FylloClip/tutorial/index.qmd

---
title: "FylloClip tutorial"
---

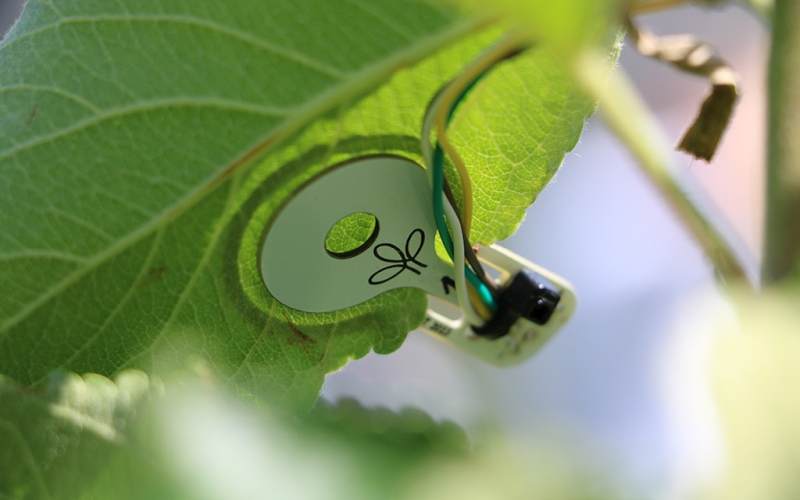
[picture p18: images/FylloClip.jpg]


This tutorial aims to enable anyone to create and deploy their own fully functional FylloClip module capable of remote data transmission via the LoRaWAN network. It will guide you from ordering PCBs (printed circuit boards), purchasing electronic components, assembling and programming the system, to setting up remote data transmission. Ultimately, this will enable you to remotely monitor the water status of plants, transmitting data from the field to the cloud. Consequently, you can check on your PC or mobile phone, anytime and anywhere, if they are experiencing water stress.

This entire system can be replicated at a very low cost and requires only basic electronics skills (like soldering) and some familiarity with microcontrollers, particularly Arduino.

**What can a FylloClip sensor do and what can't it do?**

FylloClip sensors can provide reliable indications of whether a plant is optimally supplied with water or if drought stress due to water deficiency is setting in.

FylloClip sensors do not measure transpiration rates, although the signal of the capacitive part is strongly influenced by the transpiration of the leaf. Therefore, FylloClip sensors are not porometers. They provide a qualitative information regarding the water status of a plant, and not a quantitative reference value.

**What is the ideal application area for FylloClip sensors?**

FylloClip sensors are particularly suitable for plants with deep or widely extensive root systems, where soil moisture sensors, due to their very localized measurements, have only limited significance. FylloClip sensors provide information about the general water status of plants as affected by the availability of water in the entire soil volume explored by their roots.

The scientific background and working principle of these foliar sensors, named 'FylloClip' due to their paperclip-like attachment, are explained in detail in the following publication:\
[*A leaf-mounted capacitance sensor for continuous monitoring of foliar transpiration and solar irradiance as an indicator of plant water status*](https://www.agroengineering.org/jae/article/view/1477/1066)

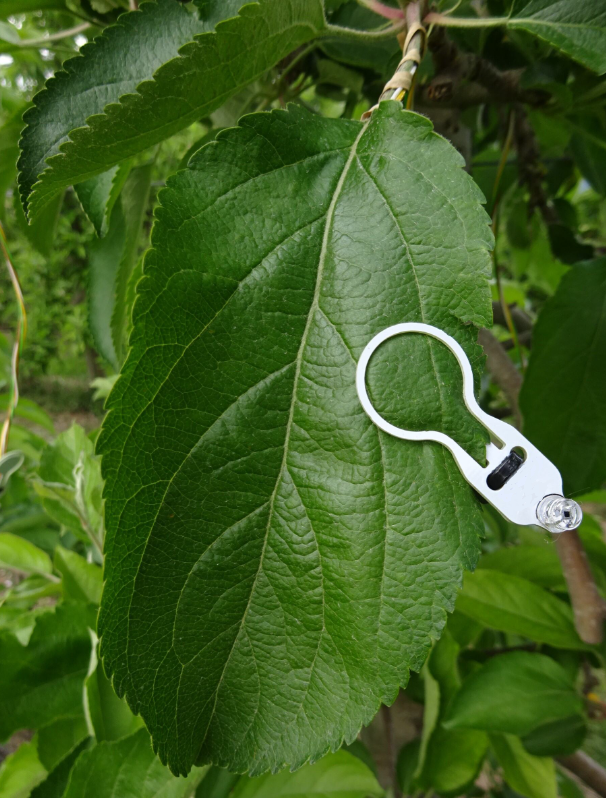
[picture p19: images/fylloclip_apple.png]
FylloClip sensor on apple leaf


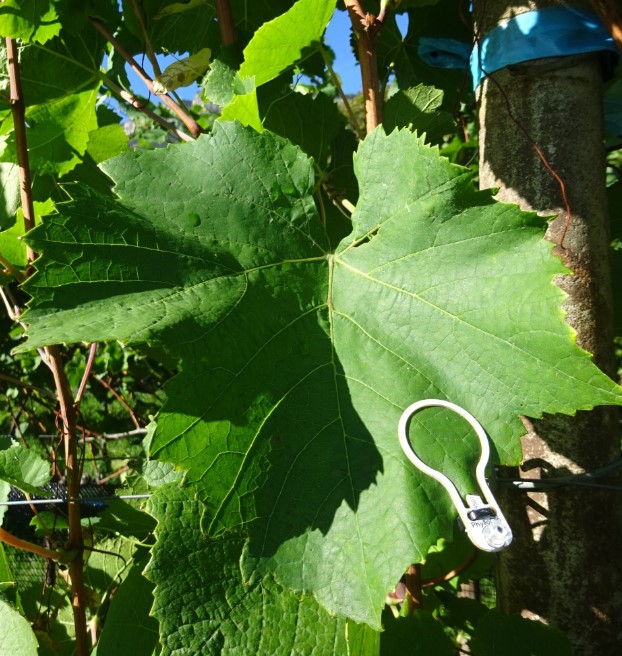
[picture p20: images/grapevine.jpg]
FylloClip on grapevine


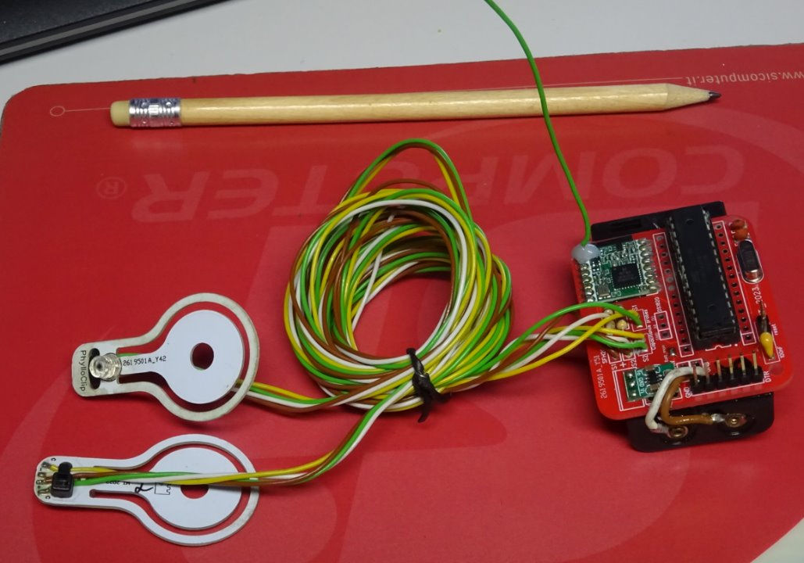
[picture p21: images/clipboard-4003555692.png]
![](images/clipboard-2063268666.png){width="440"}


A fully assembled FylloClip module

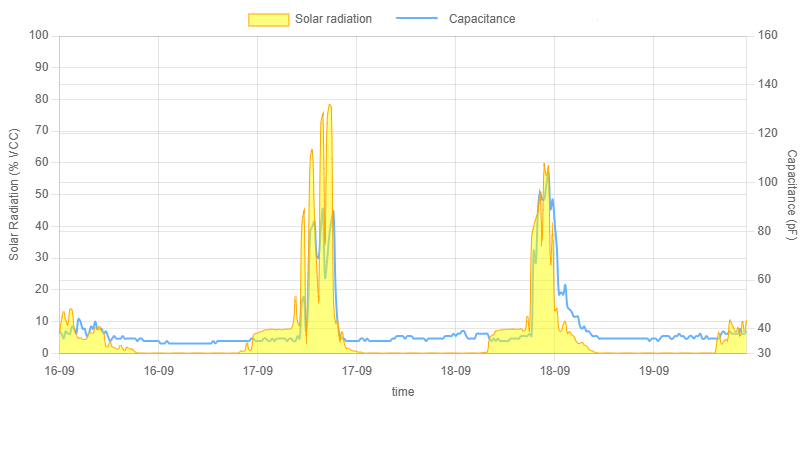
[picture p22: images/Graph_sensor_output_1.png]
Example of sensor output on a well watered plant: the capacitance values closely follow the pattern of solar radiation.


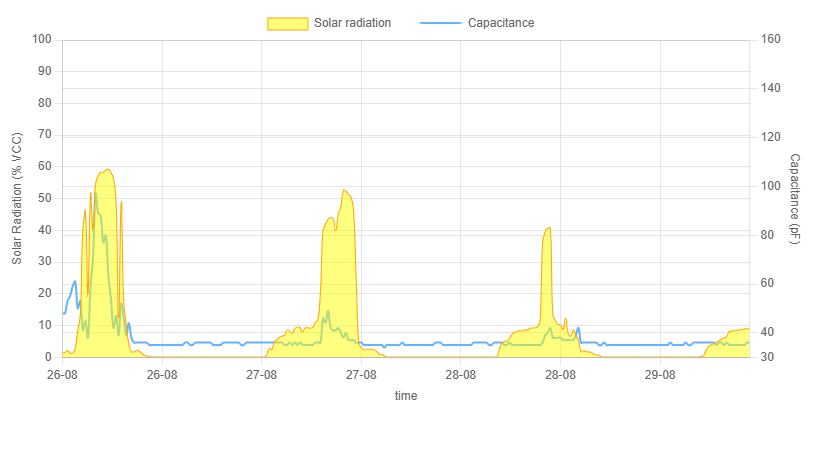
[picture p23: images/Graph_sensor_output_2.png]
Example of sensor output showing the onset of water stress through an early drop in capacitance that increasingly deviates from the pattern of solar radiation.
