FylloClip/tutorial/content/PCBs.qmd

---
title: "PCBs"
---

Here you can download the production files for the PCB needed to create the control unit (Arduino board) as well as the PCBs used as foliar sensors.

The files are provided in two different formats, gerber and EasyEDA. The gerber files can be used directly to place an order with a PCB manufacturer, whereas the EasyEDA files can be uploaded to the [EasyEDA](https://easyeda.com/ "EasyEDA PCB design software") PCB design software where they can be edited and modified before placing an order.

#### **Arduino board**

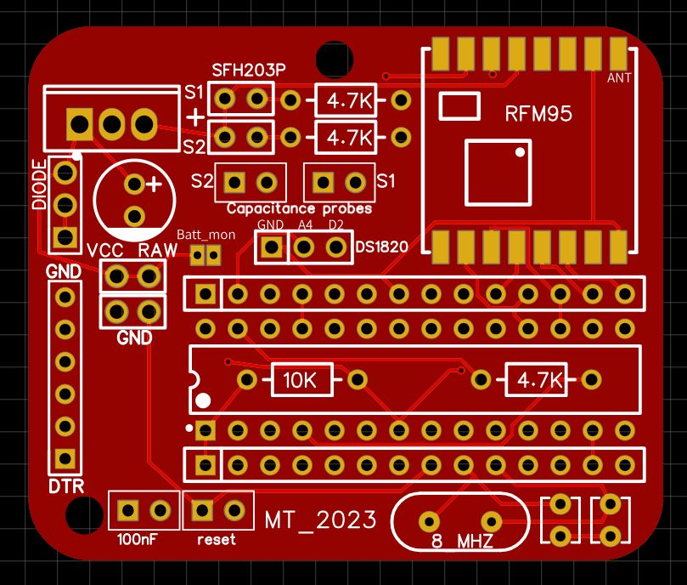
[picture p57: images/Arduino_board.jpg]
Arduino board PCB


[Gerber format](https://github.com/FylloClip/tutorial/blob/main/resources/PCB%20production%20files/Arduino_board/gerber/Gerber_PCB_Arduino_LoRa_board.zip)

[EasyEDA format](https://github.com/FylloClip/tutorial/blob/main/resources/PCB%20production%20files/Arduino_board/EasyEda/PCB_Arduino_LoRa_board.json)

#### **FylloClip sensors**

When ordering the foliar sensors, [please make sure to select a PCB **thickness of 1 mm**]{.underline}. If the thickness is more than 1 mm, the sensor will be too stiff an difficult to be placed on a leaf. I have always chosen the white colour, but probably it does not make much of a difference if you choose another colour.

**larger size:**

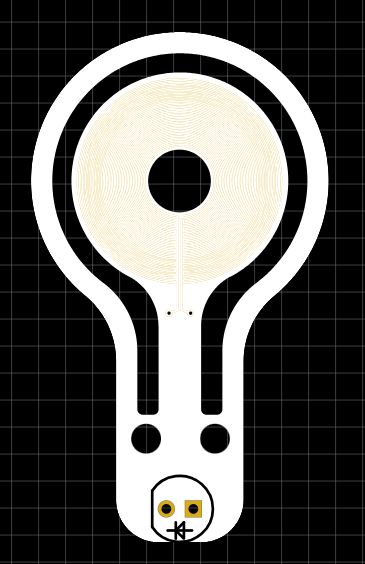
[picture p58: images/FylloClip_large_size.jpg]
foliar sensor, larger size


[Gerber format](https://github.com/FylloClip/tutorial/blob/main/resources/PCB%20production%20files/foliar_sensor/gerber/Gerber_larger_size.zip)

[EasyEDA format](https://github.com/FylloClip/tutorial/blob/main/rssources/PCB%20production%20files/foliar_sensor/EasyEda/larger_size_sensor.json)

**smaller size:**

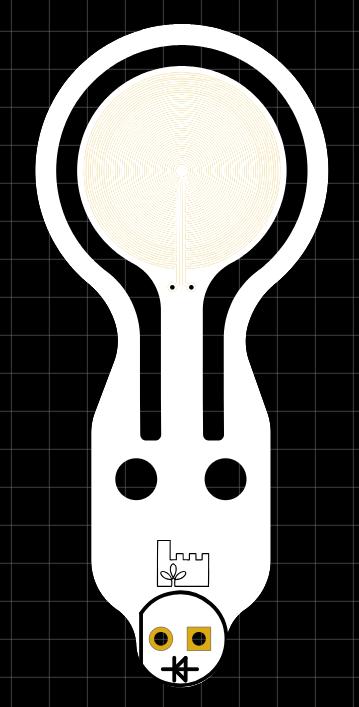
[picture p59: images/clipboard-2212851997.png]
foliar sensor, smaller size


[Gerber format](https://github.com/FylloClip/tutorial/blob/main/resources/PCB%20production%20files/foliar_sensor/gerber/Gerber_small_size.zip)

[EasyEDA format](https://github.com/FylloClip/tutorial/blob/main/resources/PCB%20production%20files/foliar_sensor/EasyEda/small_size_sensor.json)
