FylloClip/tutorial/content/data_interpretation.qmd

---
title: "data interpretation"
---

🚧 This section is under construction.
