FylloClip/tutorial/content/legal_note.qmd

---
title: "legal note"
---

All information provided in this tutorial, including schematics and code, is freely available for personal and commercial use. However, the name **"FylloClip"** is a legally protected trademark of the [**Laimburg Research Centre**](https://www.laimburg.it/en/home).\
Any commercial use of the name **"FylloClip"** requires prior formal authorization from the Laimburg Research Centre.
