FylloClip/tutorial/images/clipboard-74721871.png

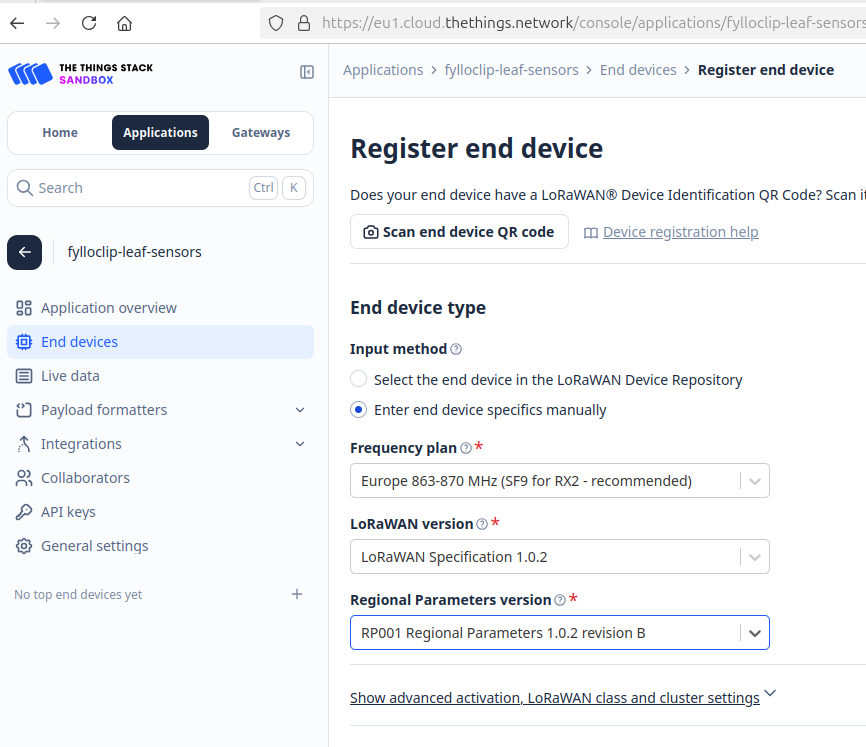
images/clipboard-74721871.png
