FylloClip/tutorial/images/clipboard-165344629.png

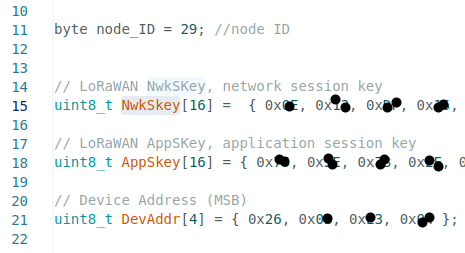
images/clipboard-165344629.png
