FylloClip/tutorial/images/clipboard-186601970.png

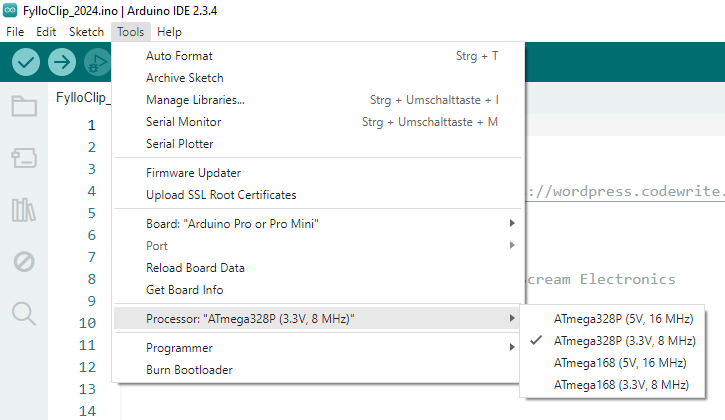
images/clipboard-186601970.png
