FylloClip/tutorial/images/clipboard-396888115.png

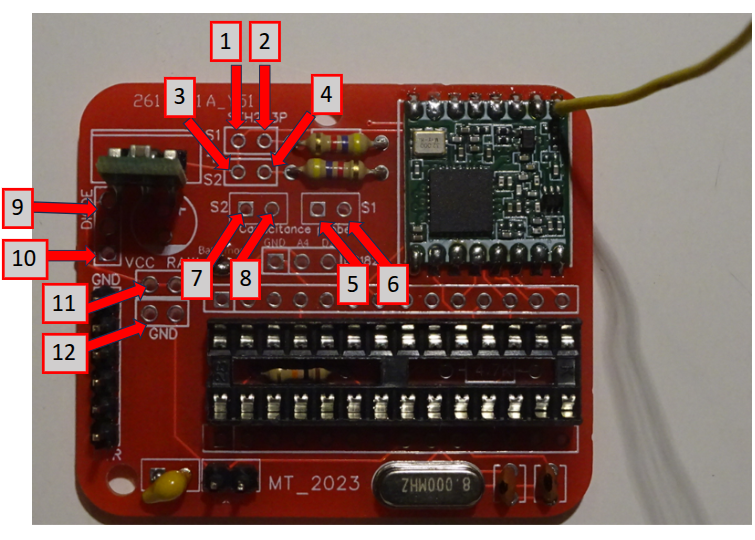
images/clipboard-396888115.png
