FylloClip/tutorial/images/clipboard-488402867.png

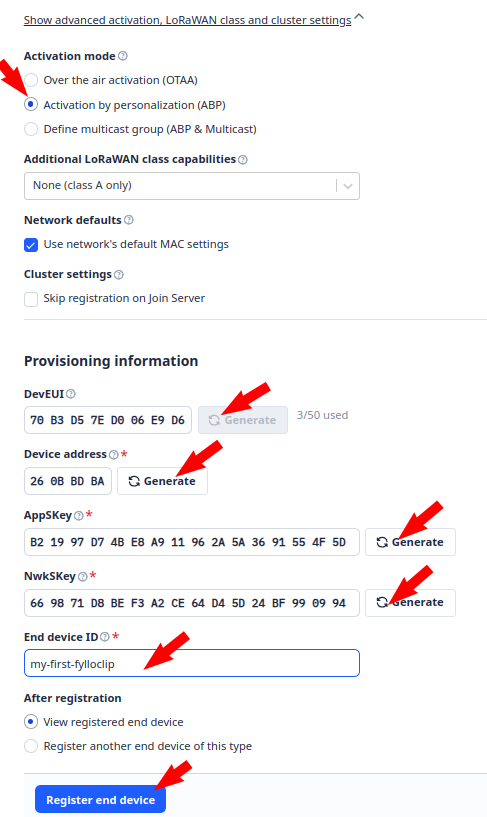
images/clipboard-488402867.png
