FylloClip/tutorial/images/clipboard-706638693.png

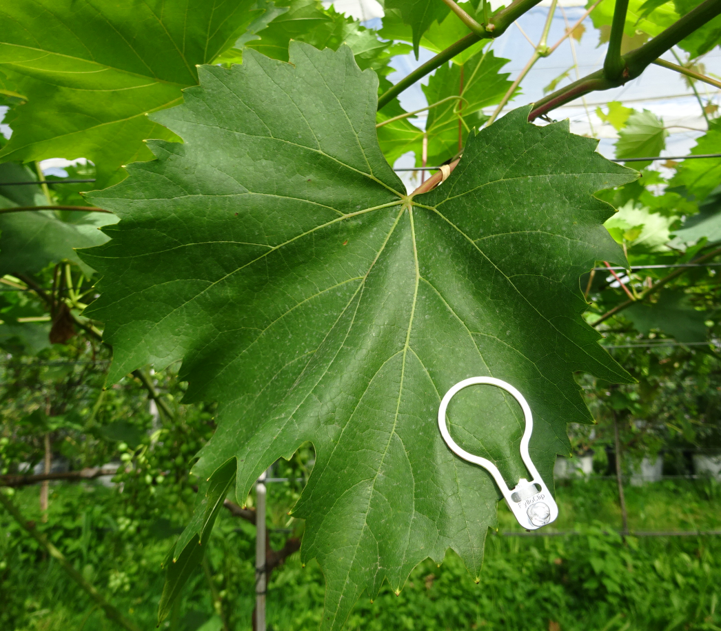
images/clipboard-706638693.png
