FylloClip/tutorial/images/clipboard-771736442.png

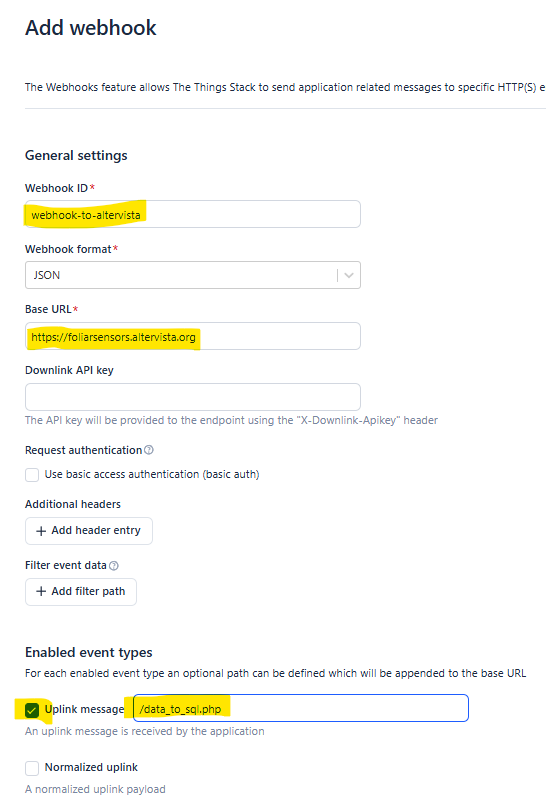
images/clipboard-771736442.png
