FylloClip/tutorial/images/clipboard-773206338.png

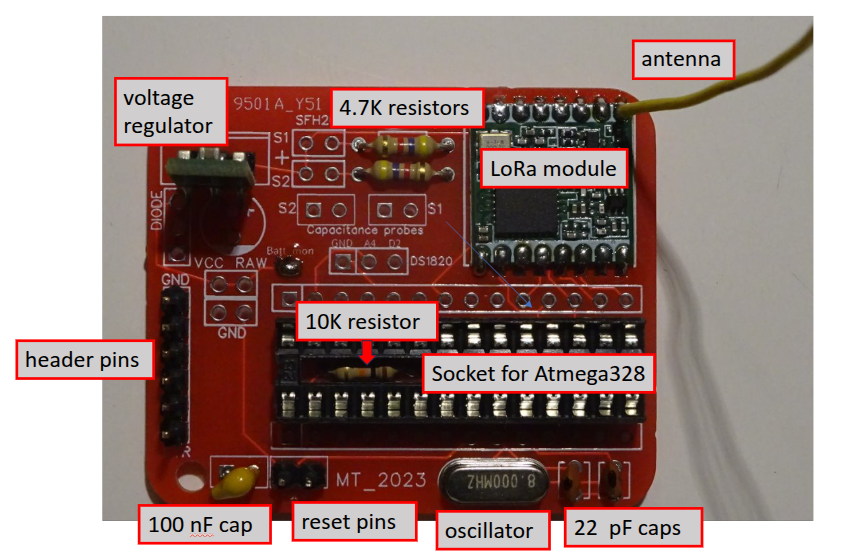
images/clipboard-773206338.png
