FylloClip/tutorial/images/clipboard-913277649.png

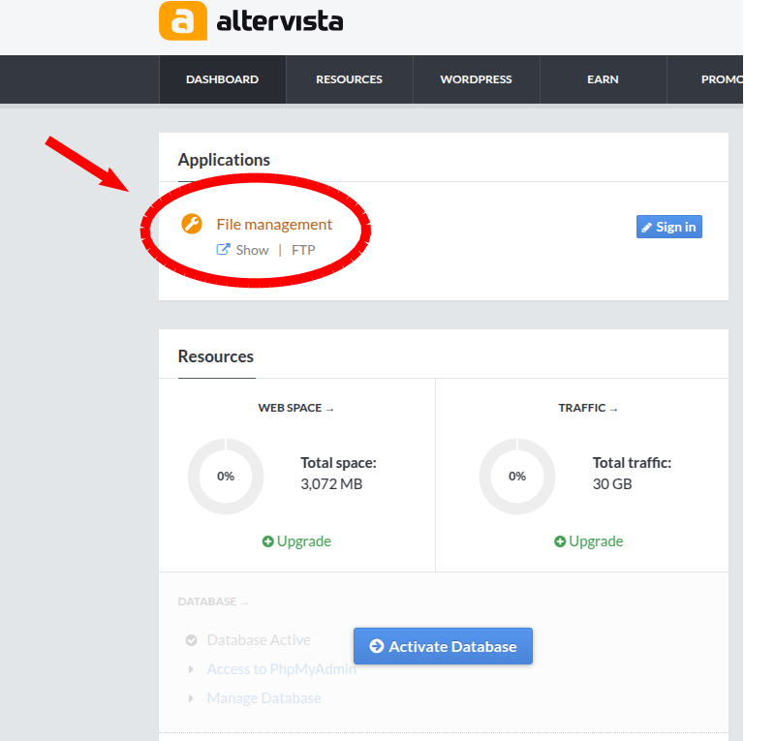
images/clipboard-913277649.png
