FylloClip/tutorial/images/clipboard-1067510384.png

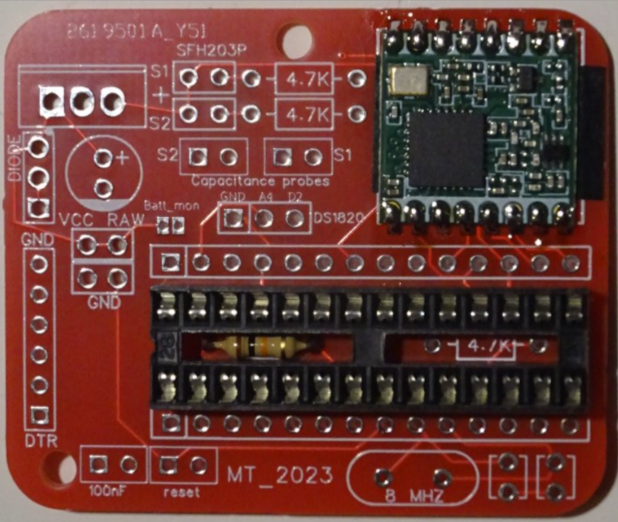
images/clipboard-1067510384.png
