FylloClip/tutorial/images/clipboard-1954534375.png

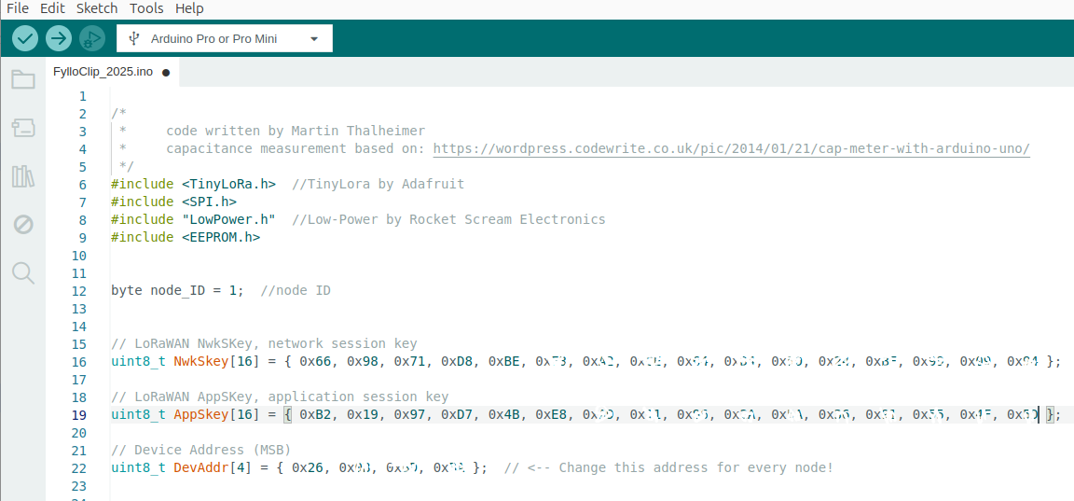
images/clipboard-1954534375.png
