FylloClip/tutorial/images/clipboard-2361992443.png

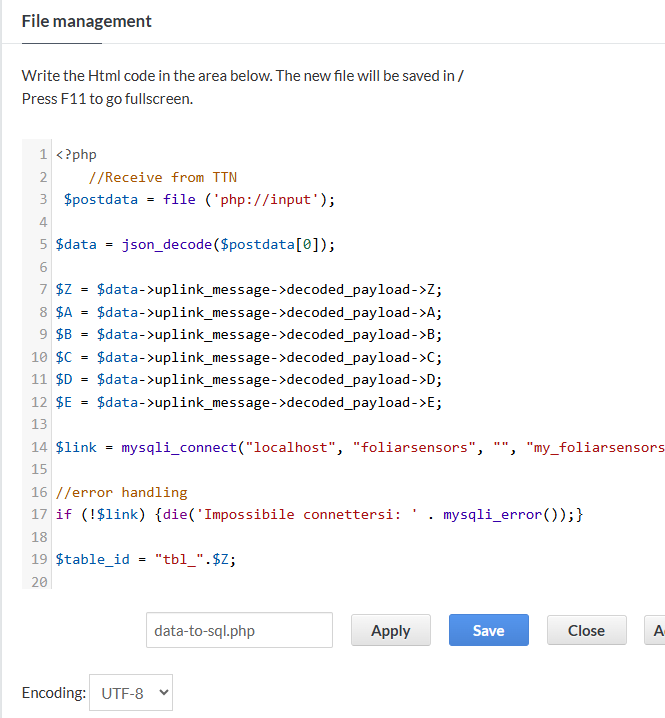
images/clipboard-2361992443.png
