FylloClip/tutorial/images/clipboard-3904533889.png

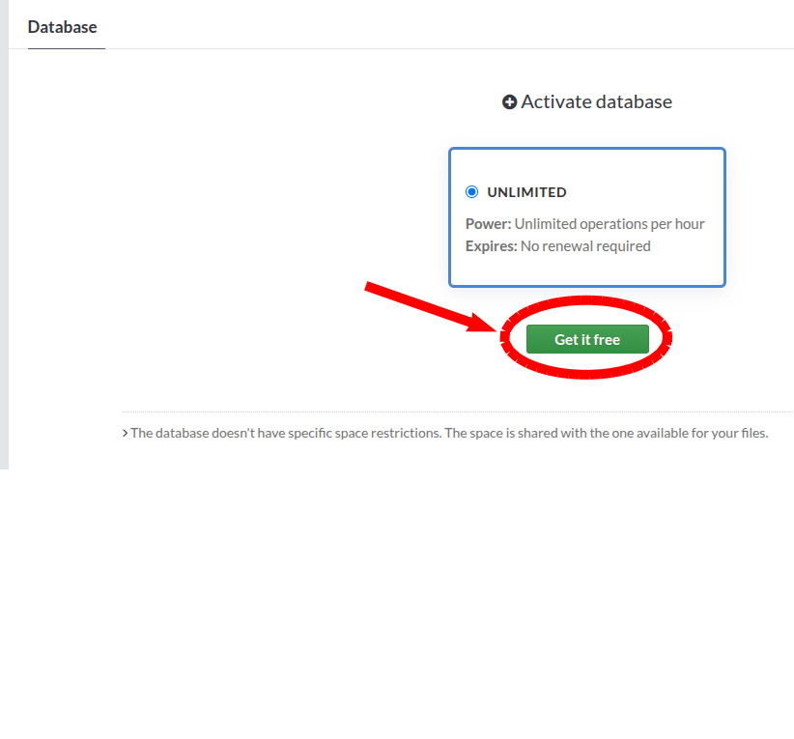
images/clipboard-3904533889.png
