FylloClip/tutorial/images/clipboard-4098331137.png

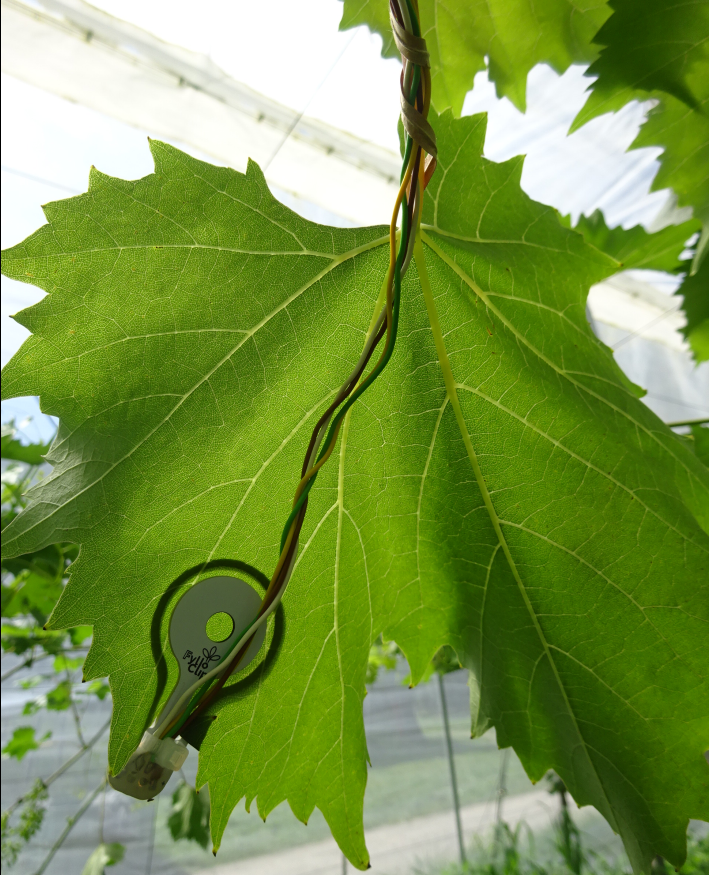
images/clipboard-4098331137.png
