FylloClip/tutorial/images/FylloClip_small_size.jpg

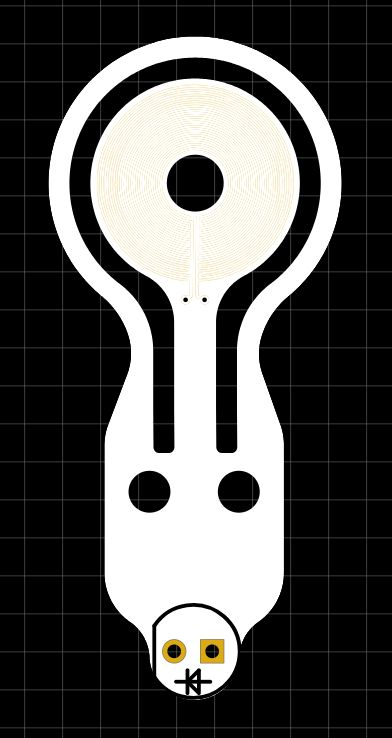
images/FylloClip_small_size.jpg
