FylloClip/tutorial/content/instructions_for_soldering.qmd

---
title: "instructions for soldering"
---

Download link for a Video showing how to solder the LoRa module onto the main PCB:

[solder RFM95](https://github.com/FylloClip/tutorial/blob/main/add_LoRa_module%20.mp4)
