FylloClip/tutorial/content/testing_the_device.qmd

---
title: "testing the device"
---

🚧 This section is under construction.
