FylloClip/tutorial/(list of files, drawings)

Other design files:
resources/PCB production files/Arduino_board/EasyEda/PCB_Arduino_LoRa_board.json
resources/PCB production files/foliar_sensor/EasyEda/larger_size_sensor.json
resources/PCB production files/foliar_sensor/EasyEda/small_size_sensor.json
