FylloClip/tutorial/(commit log)

2025-02-12 Update soldering instructions.qmd
2025-02-12 Create soldering instructions.qmd
2025-02-25 Update code for Arduino.qmd
2025-02-28 add files to ressources
    [PCB_Arduino_LoRa_board.json, larger_size_sensor.json, small_size_sensor.json]
2026-05-19 improve layout
    Improve layout and reorganize content structure
    [PCB_Arduino_LoRa_board.json, larger_size_sensor.json, small_size_sensor.json]
